kotec-le-raleur/regenerateur_pile_alcaline/Test_Ikea_graphe.jpg

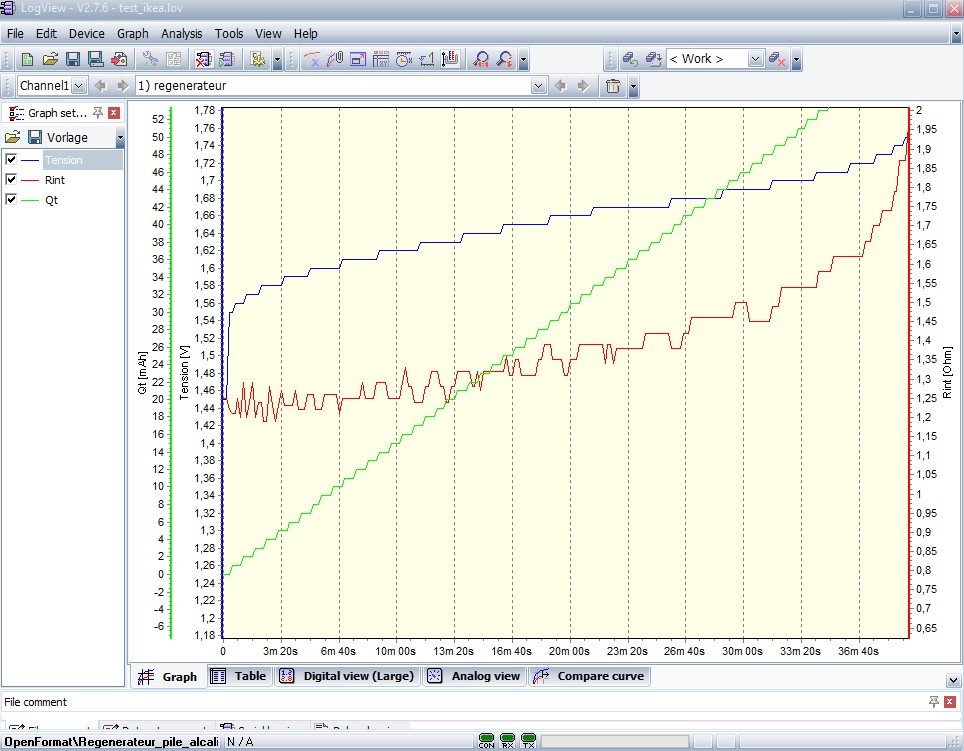
Test_Ikea_graphe.jpg
