kotec-le-raleur/regenerateur_pile_alcaline/Regenerateur_pile_alcaline.jpg

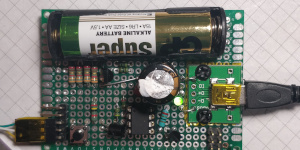
Regenerateur_pile_alcaline.jpg
