kotec-le-raleur/regenerateur_pile_alcaline/console_1.jpg

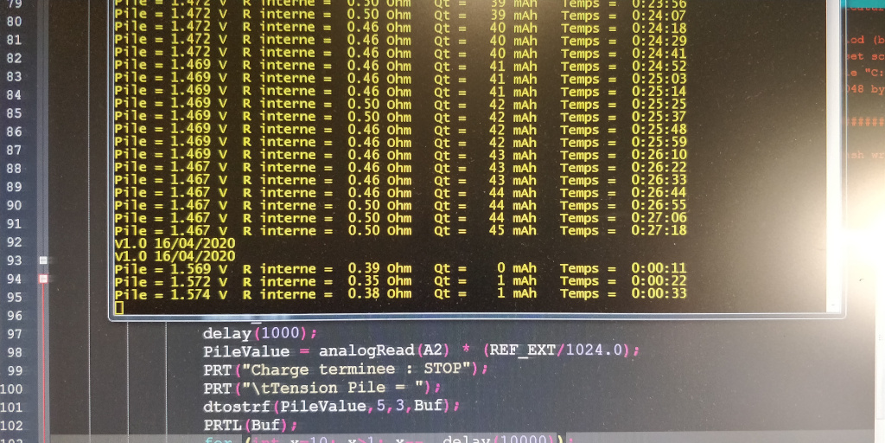
console_1.jpg
