kotec-le-raleur/regenerateur_pile_alcaline/console_2.jpg

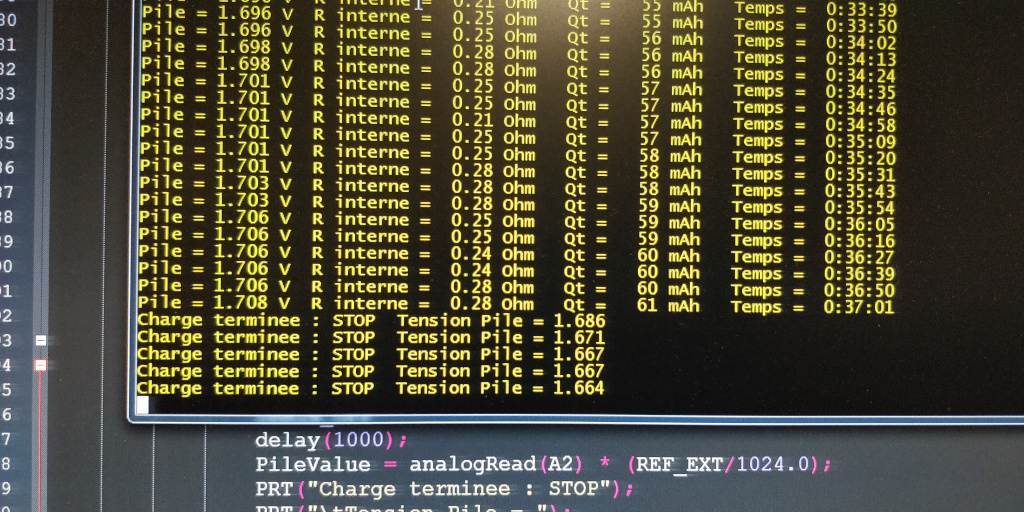
console_2.jpg
