kotec-le-raleur/regenerateur_pile_alcaline/schema_regenerateur.pdf

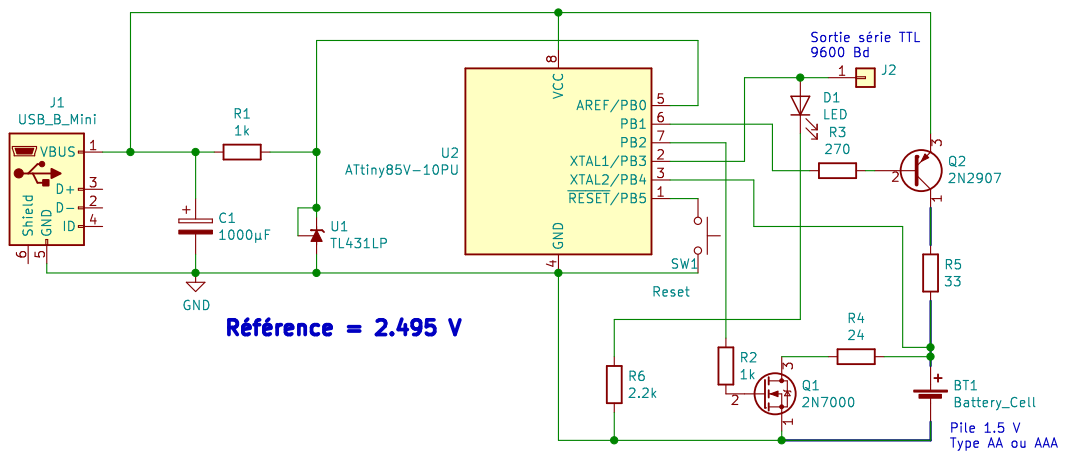
[picture p5: page 1]
